GadgetReboot/S_NES_Controller_Breakout/README.md

# S_NES_Controller_Breakout
Breakout board to decode NES or SNES controller buttons as separate GPIO outputs from ATTiny26
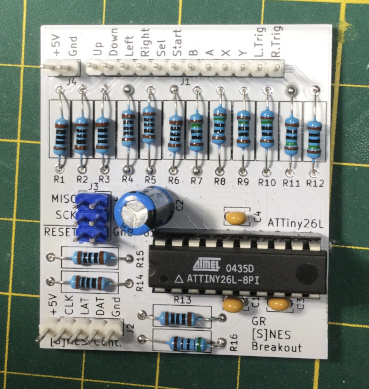
[picture p1: Assembled_PCB.jpg]
PCB
<br><br><br><br>
