GadgetReboot/S_NES_Controller_Breakout/sketches/readme.md

Demo sketch for NES and for SNES<br>
Clocks the controller 4021 shift register, reading out the bits that represent the controller button states.<br><br>
Those bits are then latched on outputs of the ATTiny26, showing a real time pressed/released state of each button.
