GadgetReboot/S_NES_Controller_Breakout/GR_SNES_Breakout_Sch.pdf

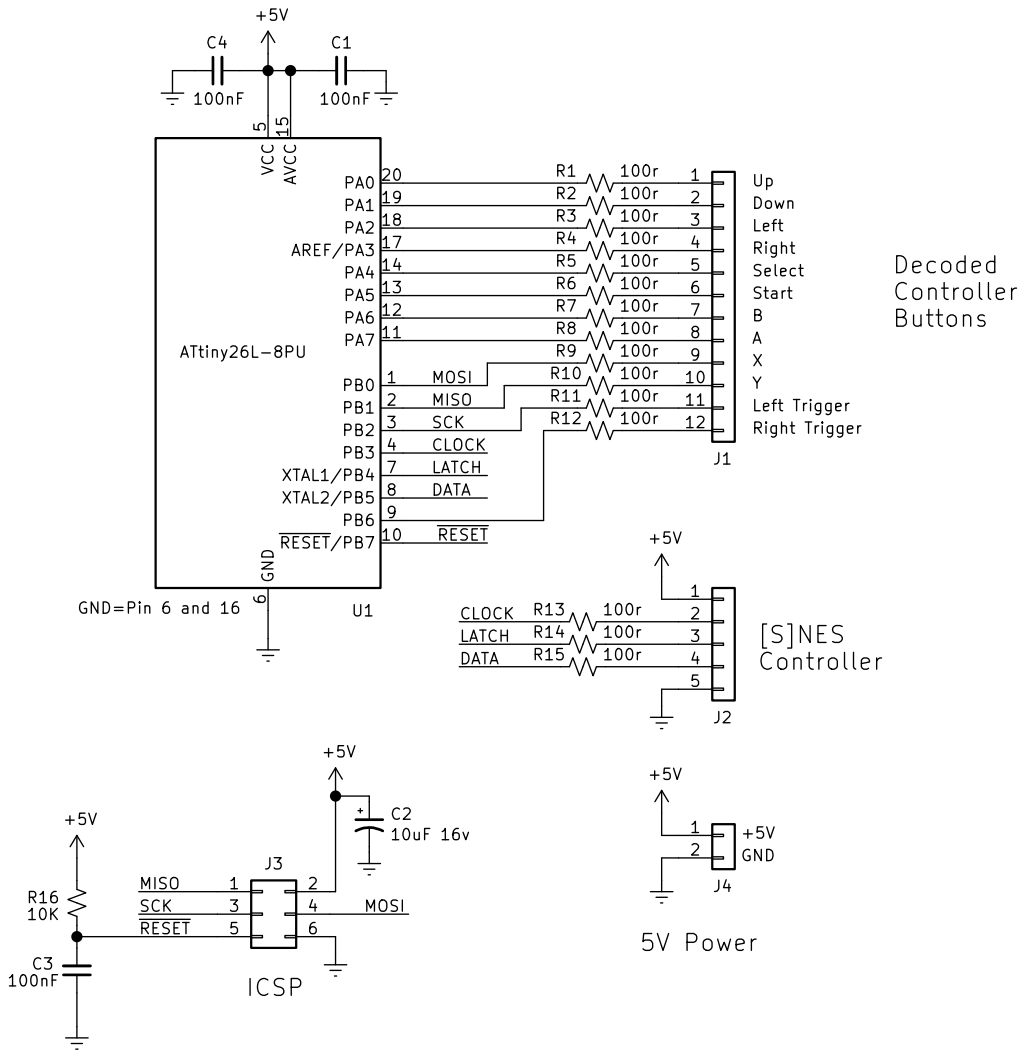
[picture p2: page 1]

Up Down
Left Right Select Start BAXY

https://github.com/GadgetReboot/S_NES_Controller_Breakout
https://www.youtube.com/gadgetreboot
File: GR_SNES_Breakout.sch Sheet: / Gadget Reboot

Id: 1/1 Title: [S]NES Controller Breakout
