GadgetReboot/S_NES_Controller_Breakout/KiCad/GR_SNES_Breakout.kicad_pcb

## KiCad design KiCad/GR_SNES_Breakout.kicad_pcb (2023-06-15)

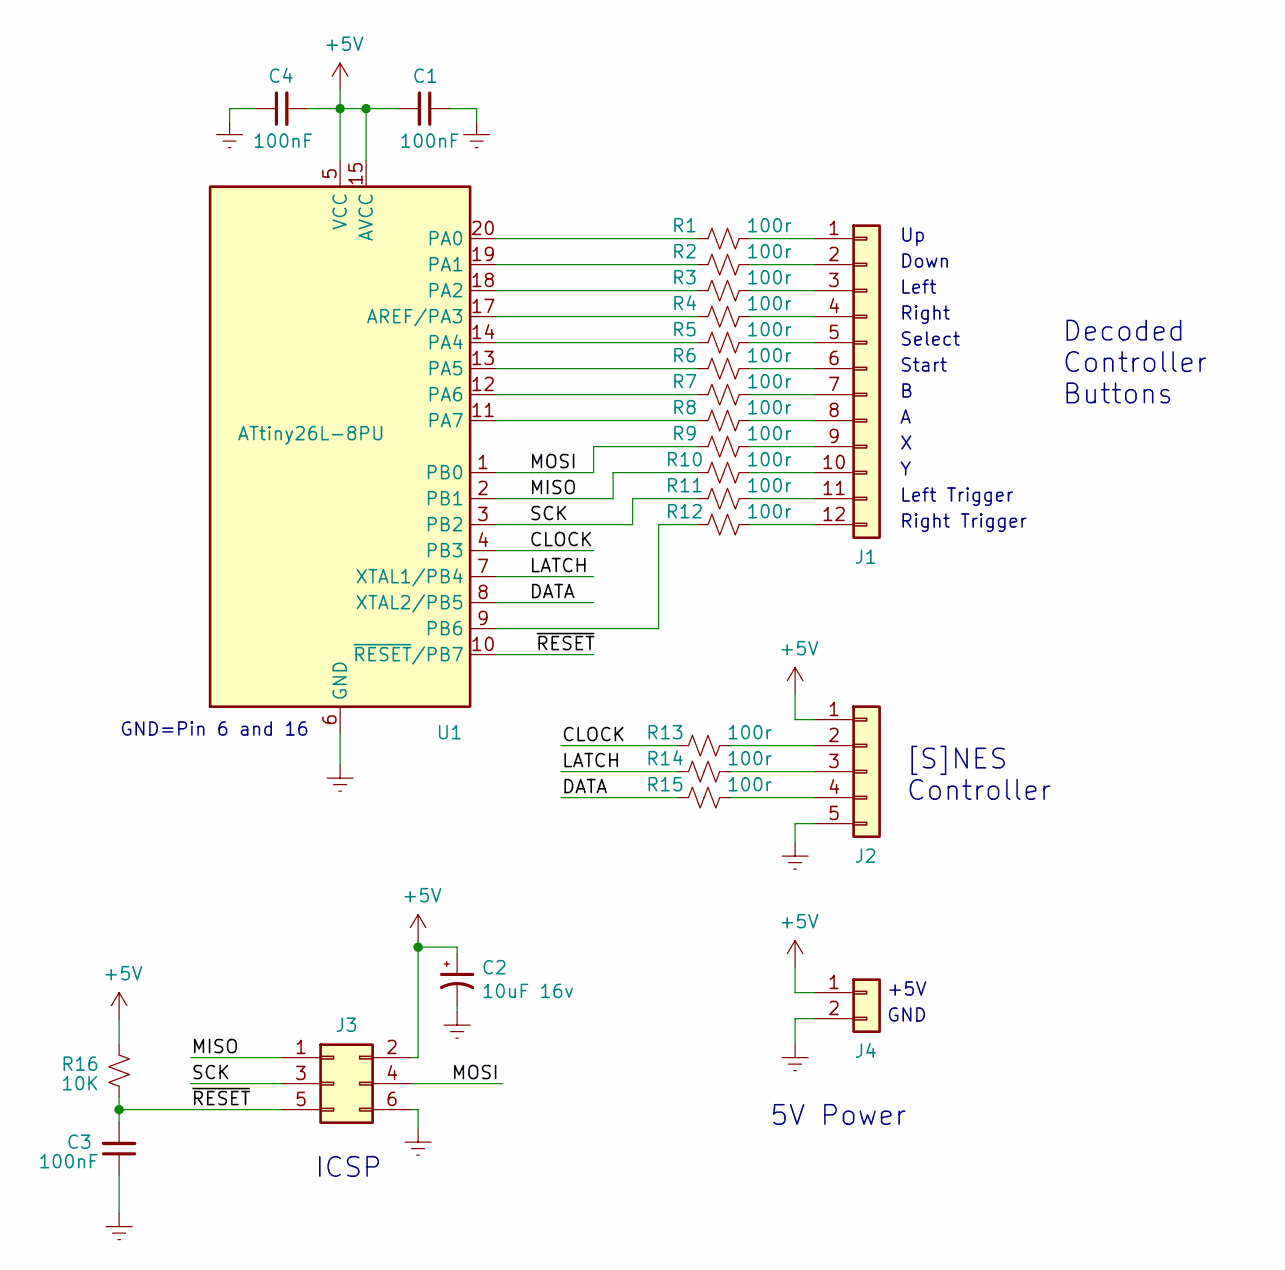
[picture p3: schematic GR_SNES_Breakout.sch, [S]NES Controller Breakout]

Parts:
C1, C3, C4: 100nF; C_Disc_D3.8mm_W2.6mm_P2.50mm
C2: 10uF 16v; CP_Radial_D5.0mm_P2.50mm
J1: Conn_01x12; PinHeader_1x12_P2.54mm_Vertical
J2: Conn_01x05; PinHeader_1x05_P2.54mm_Vertical
J3: Conn_02x03_Odd_Even; PinHeader_2x03_P2.54mm_Vertical
J4: Conn_01x02; PinHeader_1x02_P2.54mm_Vertical
R1, R2, R3, R4, R5, R6, R7, R8, R9, R10, R11, R12, R13, R14, R15: 100r; R_Axial_DIN0309_L9.0mm_D3.2mm_P12.70mm_Horizontal
R16: 10K; R_Axial_DIN0309_L9.0mm_D3.2mm_P12.70mm_Horizontal
U1: ATtiny26L-8PU; DIP-20_W7.62mm

Connections:
+5V: C1.2, C2.1, C4.2, J2.1, J3.2, J4.1, R16.1, U1.5 (VCC), U1.15 (AVCC)
/CLOCK: R13.1, U1.4 (PB3)
/DATA: R15.1, U1.8 (XTAL2/PB5)
/LATCH: R14.1, U1.7 (XTAL1/PB4)
/MISO: J3.1, R10.1, U1.2 (PB1)
/MOSI: J3.4, R9.1, U1.1 (PB0)
/SCK: J3.3, R11.1, U1.3 (PB2)
/~RESET: C3.2, J3.5, R16.2, U1.10 (~RESET~/PB7)
GNDREF: C1.1, C2.2, C3.1, C4.1, J2.5, J3.6, J4.2, U1.6 (GND), U1.16 (GND)
unnamed: J1.1, R1.2
unnamed: J1.2, R2.2
unnamed: J1.3, R3.2
unnamed: J1.4, R4.2
unnamed: J1.5, R5.2
unnamed: J1.6, R6.2
unnamed: J1.7, R7.2
unnamed: J1.8, R8.2
unnamed: J1.9, R9.2
unnamed: J1.10, R10.2
unnamed: J1.11, R11.2
unnamed: J1.12, R12.2
unnamed: J2.2, R13.2
unnamed: J2.3, R14.2
unnamed: J2.4, R15.2
unnamed: R1.1, U1.20 (PA0)
unnamed: R2.1, U1.19 (PA1)
unnamed: R3.1, U1.18 (PA2)
unnamed: R4.1, U1.17 (AREF/PA3)
unnamed: R5.1, U1.14 (PA4)
unnamed: R6.1, U1.13 (PA5)
unnamed: R7.1, U1.12 (PA6)
unnamed: R8.1, U1.11 (PA7)
unnamed: R12.1, U1.9 (PB6)

Notes on the sheet:
[S]NES Controller
GND=Pin 6 and 16
ICSP
Down
Left
Right
Select
Start
Left Trigger
Right Trigger
Decoded Controller Buttons
5V Power
+5V
GND

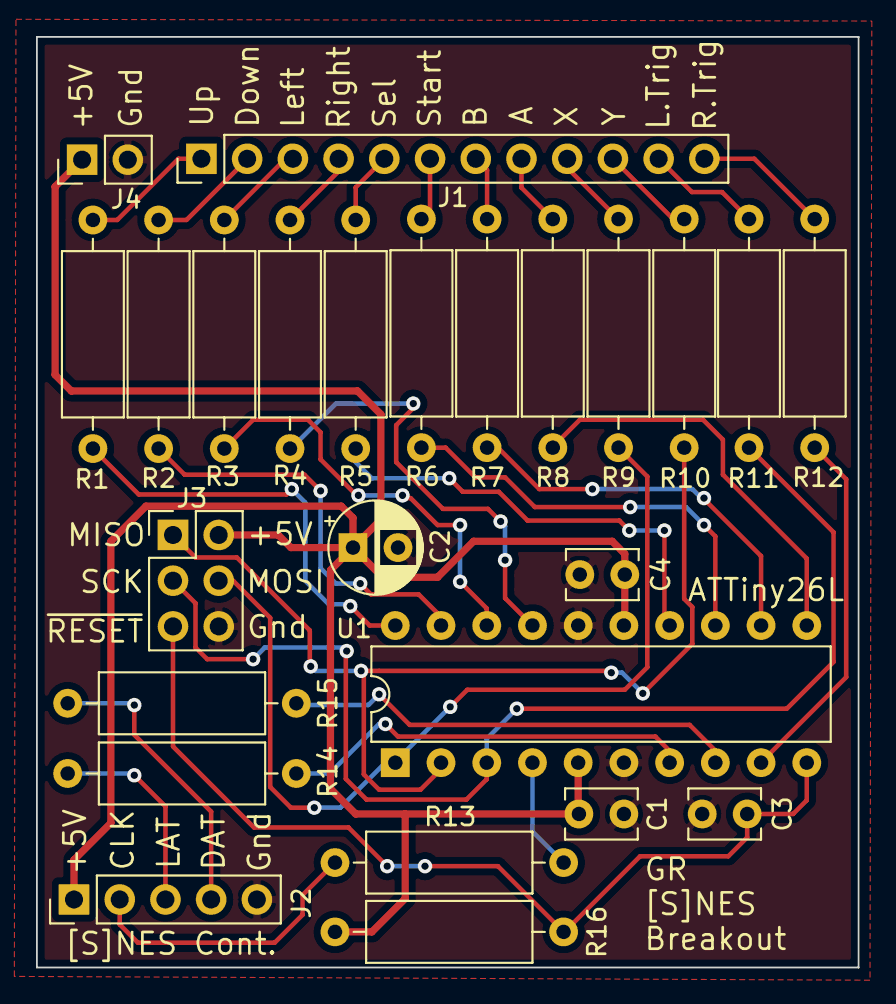
[picture p4: board GR_SNES_Breakout.kicad_pcb from above]

Board: 2 copper layers, 45.7 x 51.7 mm, 25 parts (0 on the bottom side), 33 nets.
